LucSys-Robotics/technical-resources/platforms/lucsys_lsr280_description/meshes/lsr280/lb_wheel_link.STL

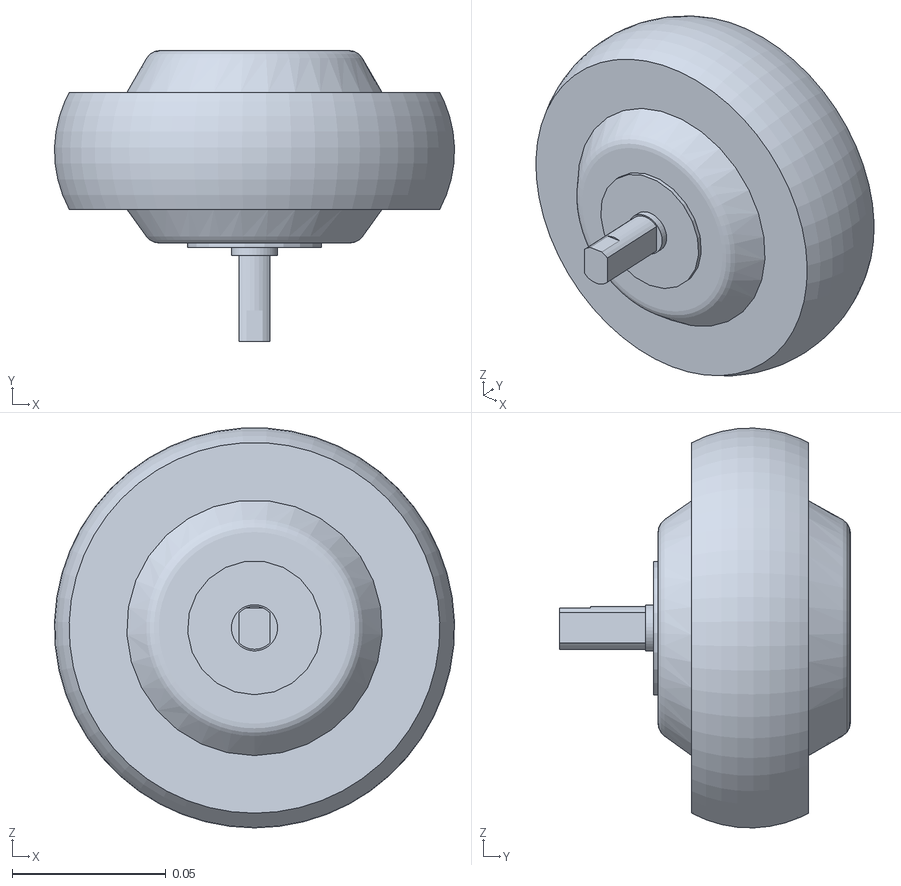
[picture p1: CAD file, 2026-11-02]
platforms/lucsys_lsr280_description/meshes/lsr280/lb_wheel_link.STL
0.13 x 0.0945 x 0.13
