LucSys-Robotics/technical-resources/platforms/lucsys_lsr280_description/meshes/lsr280/lf_steer_link.STL

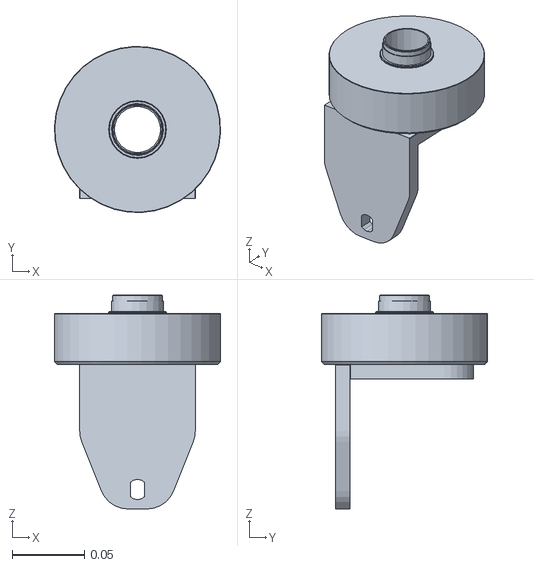
[picture p3: CAD file, 2026-11-02]
platforms/lucsys_lsr280_description/meshes/lsr280/lf_steer_link.STL
0.115 x 0.115 x 0.148
