LucSys-Robotics/technical-resources/platforms/lucsys_lsr280_description/meshes/lsr280/column_base_link.STL

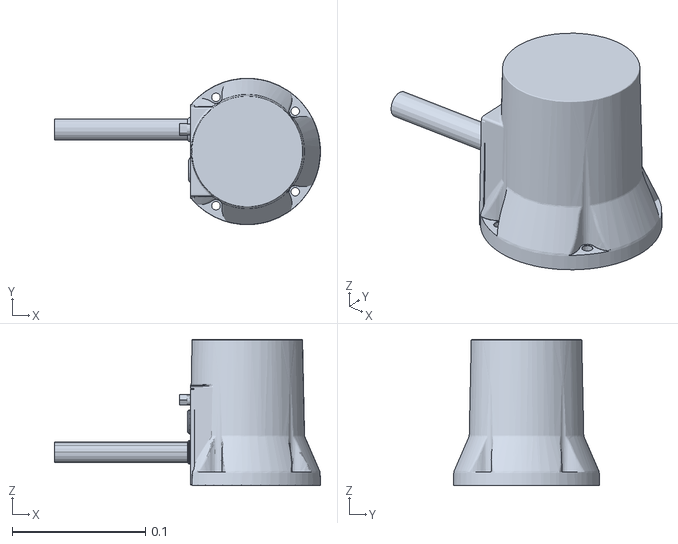
[picture p4: CAD file, 2026-11-02]
platforms/lucsys_lsr280_description/meshes/lsr280/column_base_link.STL
0.2 x 0.11 x 0.11
