LucSys-Robotics/technical-resources/platforms/lucsys_lsr280_description/meshes/lsr280/base_link.STL

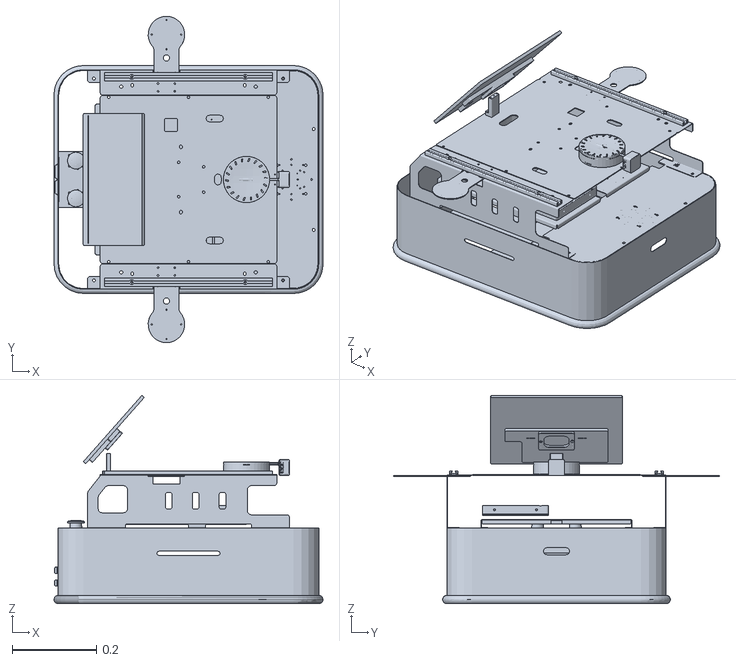
[picture p5: CAD file, 2026-11-02]
platforms/lucsys_lsr280_description/meshes/lsr280/base_link.STL
0.64 x 0.776 x 0.496
