LucSys-Robotics/technical-resources/platforms/lucsys_lsr280_description/meshes/lsr280/laser_link.STL

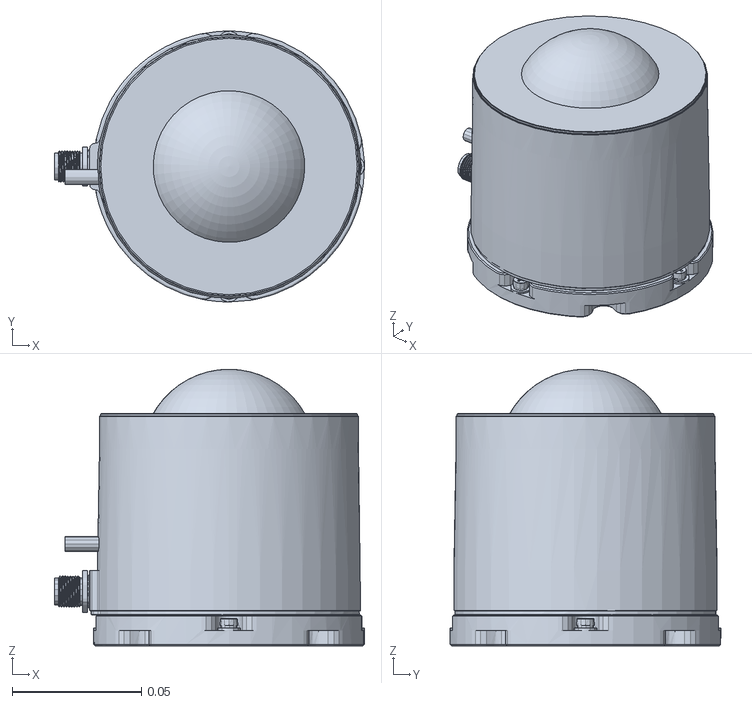
[picture p6: CAD file, 2026-11-02]
platforms/lucsys_lsr280_description/meshes/lsr280/laser_link.STL
0.12 x 0.105 x 0.107
