LucSys-Robotics/technical-resources/(list of files, cad)

Other CAD files:
platforms/lucsys_lsr280_description/meshes/lsr280/rb_steer_link.STL
platforms/lucsys_lsr280_description/meshes/lsr280/rf_steer_link.STL
platforms/lucsys_lsr280_description/meshes/lsr280/lb_steer_link.STL
platforms/lucsys_lsr280_description/meshes/lsr280/rf_wheel_link.STL
