LucSys-Robotics/technical-resources/platforms/lucsys_lse550_description/urdf/lse550_tank.urdf

<?xml version="1.0" encoding="utf-8"?>
<robot name="lucsys_lse550_tank">
  <link name="base_link">
    <inertial>
      <origin xyz="0.0128905244105685 -0.000195995781382477 0.0193846775523578" rpy="0 0 0" />
      <mass value="0.574921488094907" />
      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
    </inertial>
    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
  </link>
  <link name="left1_link">
    <inertial>
      <origin xyz="3.06748764722364E-07 -0.00213348686434228 6.14172601665075E-12" rpy="0 0 0" />
      <mass value="0.0074113156920016" />
      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
    </inertial>
    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
  </link>
  <joint name="left1_joint" type="continuous">
    <origin xyz="0.115209579465965 0.114103937103155 0.0105000000000004" rpy="0 0 0" />
    <parent link="base_link" />
    <child link="left1_link" />
    <axis xyz="0 -1 0" />
  </joint>
  <link name="left2_link">
    <inertial>
      <origin xyz="-4.7006518005821E-07 -0.00301016528738202 3.65847359865001E-07" rpy="0 0 0" />
      <mass value="0.00699327949467042" />
      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
    </inertial>
    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
  </link>
  <joint name="left2_joint" type="continuous">
    <origin xyz="0.0718895794659653 0.114303937103155 -0.0162779999999998" rpy="0 0 0" />
    <parent link="base_link" />
    <child link="left2_link" />
    <axis xyz="0 -1 0" />
  </joint>
  <link name="left3_link">
    <inertial>
      <origin xyz="-4.70065180085966E-07 -0.00301016528738202 3.65847359878879E-07" rpy="0 0 0" />
      <mass value="0.00699327949467042" />
      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
    </inertial>
    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
  </link>
  <joint name="left3_joint" type="continuous">
    <origin xyz="0.0268895794659653 0.114303937103156 -0.0162779999999999" rpy="0 0 0" />
    <parent link="base_link" />
    <child link="left3_link" />
    <axis xyz="0 -1 0" />
  </joint>
  <link name="left4_link">
    <inertial>
      <origin xyz="-4.70065180086399E-07 -0.00301016528738203 3.65847359878879E-07" rpy="0 0 0" />
      <mass value="0.00699327949467042" />
      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
    </inertial>
    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
  </link>
  <joint name="left4_joint" type="continuous">
    <origin xyz="-0.0181104205340347 0.114303937103156 -0.0162780000000001" rpy="0 0 0" />
    <parent link="base_link" />
    <child link="left4_link" />
    <axis xyz="0 -1 0" />
  </joint>
  <link name="left5_link">
    <inertial>
      <origin xyz="-4.70065180113721E-07 -0.00301016528738204 3.65847359892757E-07" rpy="0 0 0" />
      <mass value="0.00699327949467042" />
      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
    </inertial>
    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
  </link>
  <joint name="left5_joint" type="continuous">
    <origin xyz="-0.0631104205340347 0.114303937103156 -0.0162780000000002" rpy="0 0 0" />
    <parent link="base_link" />
    <child link="left5_link" />
    <axis xyz="0 -1 0" />
  </joint>
  <link name="left6_link">
    <inertial>
      <origin xyz="3.06747520051331E-07 -0.00937089235015534 -9.99200722162641E-16" rpy="0 0 0" />
      <mass value="0.00924268883262038" />
      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
    </inertial>
    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
  </link>
  <joint name="left6_joint" type="continuous">
    <origin xyz="-0.107290420534035 0.114330937103156 0.0104999999999996" rpy="0 0 0" />
    <parent link="base_link" />
    <child link="left6_link" />
    <axis xyz="0 -1 0" />
  </joint>
  <link name="right1_link">
    <inertial>
      <origin xyz="3.06746499506572E-07 0.00213389422794183 7.18869408444789E-15" rpy="0 0 0" />
      <mass value="0.00741131569893439" />
      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
    </inertial>
    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
  </link>
  <joint name="right1_joint" type="continuous">
    <origin xyz="0.115209579465964 -0.114354062896845 0.0105000000000004" rpy="0 0 0" />
    <parent link="base_link" />
    <child link="right1_link" />
    <axis xyz="0 -1 0" />
  </joint>
  <link name="right2_link">
    <inertial>
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
